Jhonier-Rojas/proyecto-modulo-meteorologico-esp32-s3/PI__SEMESTRE.kicad_pcb

## KiCad design PI__SEMESTRE.kicad_pcb (2026-05-23)

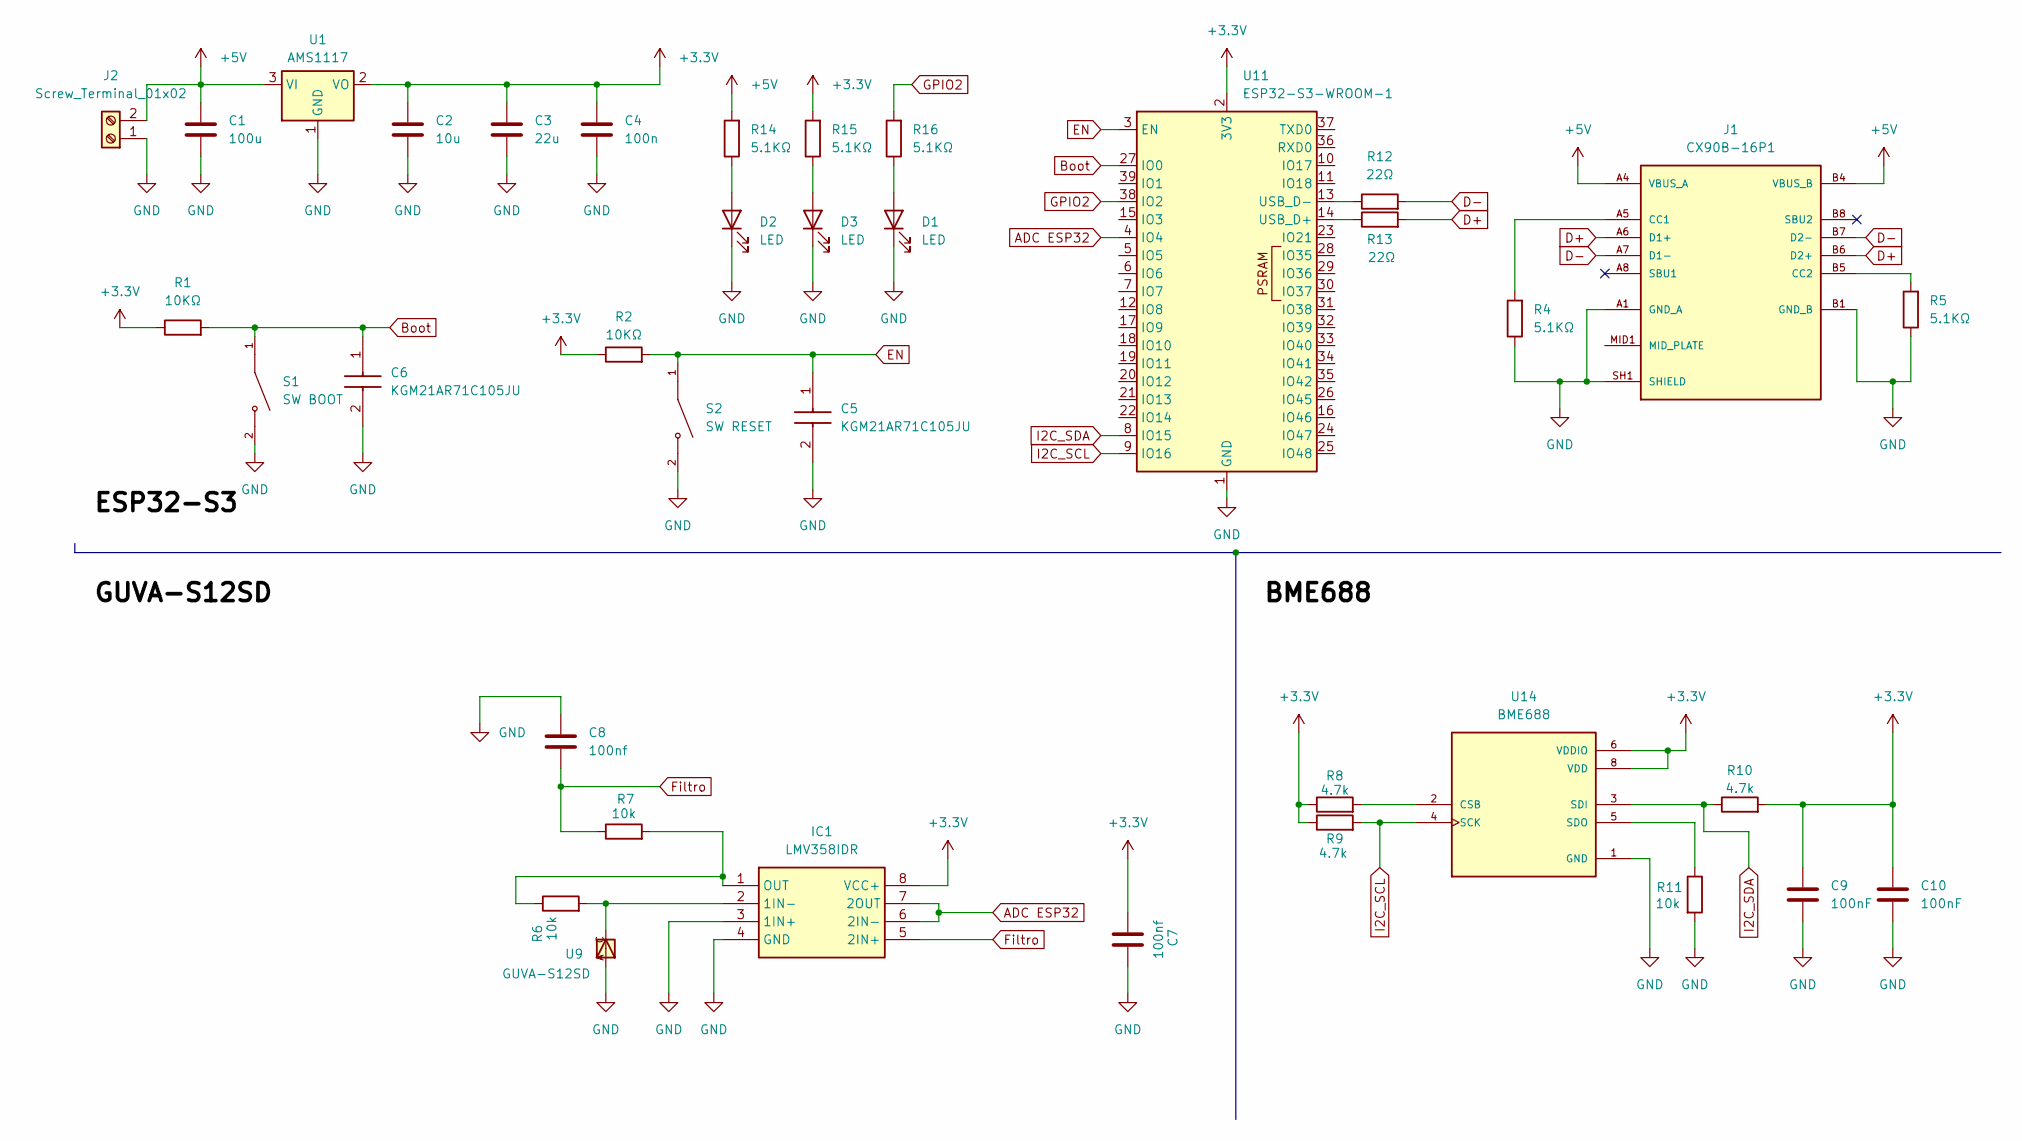
[picture p1: schematic PI__SEMESTRE.kicad_sch]

Parts:
C1: 100u; C_0805_2012Metric
C2: 10u; C_0805_2012Metric
C3: 22u; C_0805_2012Metric
C4: 100n; C_0805_2012Metric
C5, C6: KGM21AR71C105JU; CAPC2012X145N; Mouser Part Number 581-KGM21AR71C105JU
C7, C8: 100nf; C_0805_2012Metric
C9, C10: 100nF; C_0805_2012Metric
D1, D2, D3: LED; LED_1206_3216Metric
IC1: LMV358IDR; SOIC127P600X175-8N; Mouser Part Number 595-LMV358IDR
J1: CX90B-16P1; HIROSE_CX90B-16P1; PARTREV 23.04.05
J2: Screw_Terminal_01x02
R1, R2: 10KΩ; R_0805_2012Metric
R4, R5, R14, R15, R16: 5.1KΩ; R_0805_2012Metric
R6, R7, R11: 10k; R_0805_2012Metric
R8, R9, R10: 4.7k; R_0805_2012Metric
R12, R13: 22Ω; R_0805_2012Metric
S1: SW BOOT; SW_TS-1088-AR02016; PARTREV N/A
S2: SW RESET; SW_TS-1088-AR02016; PARTREV N/A
U1: AMS1117; SOT-223-3_TabPin2
U9: GUVA-S12SD; MPN GUVA-S12SD
U11: ESP32-S3-WROOM-1; XCVR_ESP32-S3-WROOM-1U-N16R8
U14: BME688; IC_BME688; PARTREV 1.0

Connections:
+3.3V: C2.1, C3.1, C4.1, C7.2, C9.1, C10.1, IC1.8 (VCC+), R1.1, R2.1, R8.1, R9.1, R10.2, R15.2, U1.2 (VO), U11.2 (3V3), U14.6 (VDDIO), U14.8 (VDD)
+5V: C1.1, J1.A4 (VBUS_A), J1.A9 (VBUS_A), J1.B4 (VBUS_B), J1.B9 (VBUS_B), J2.2, R14.2, U1.3 (VI)
ADC ESP32: IC1.6 (2IN-), IC1.7 (2OUT), U11.4 (IO4)
Boot: C6.1, R1.2, S1.1, U11.27 (IO0)
D+: J1.A6 (D1+), J1.B6 (D2+), R13.2
D-: J1.A7 (D1-), J1.B7 (D2-), R12.2
EN: C5.1, R2.2, S2.1, U11.3 (EN)
Filtro: C8.1, IC1.5 (2IN+), R7.1
GND: C1.2, C2.2, C3.2, C4.2, C5.2, C6.2, C7.1, C8.2, C9.2, C10.2, D1.1 (K), D2.1 (K), D3.1 (K), IC1.3 (1IN+), IC1.4 (GND), J1.A1 (GND_A), J1.A12 (GND_A), J1.B1 (GND_B), J1.B12 (GND_B), J1.SH1 (SHIELD), J1.SH2 (SHIELD), J1.SH3 (SHIELD), J1.SH4 (SHIELD), J1.SH5 (SHIELD), J1.SH6 (SHIELD), J2.1, R4.1, R5.1, R11.2, S1.2, S2.2, U1.1 (GND), U9.A, U11.1 (GND), U11.40 (GND), U11.41 (GND), U14.1 (GND), U14.7 (GND)
GPIO2: R16.2, U11.38 (IO2)
I2C_SCL: R9.2, U11.9 (IO16), U14.4 (SCK)
I2C_SDA: R10.1, U11.8 (IO15), U14.3 (SDI)
unnamed: D1.2 (A), R16.1
unnamed: D2.2 (A), R14.1
unnamed: D3.2 (A), R15.1
unnamed: IC1.2 (1IN-), R6.2, U9.C
unnamed: IC1.1 (OUT), R6.1, R7.2
unnamed: J1.A5 (CC1), R4.2
unnamed: J1.B5 (CC2), R5.2
unnamed: J1.MID1 (MID_PLATE), J1.MID2 (MID_PLATE)
unnamed: R13.1, U11.14 (USB_D+)
unnamed: R12.1, U11.13 (USB_D-)
unnamed: R8.2, U14.2 (CSB)
unnamed: R11.1, U14.5 (SDO)

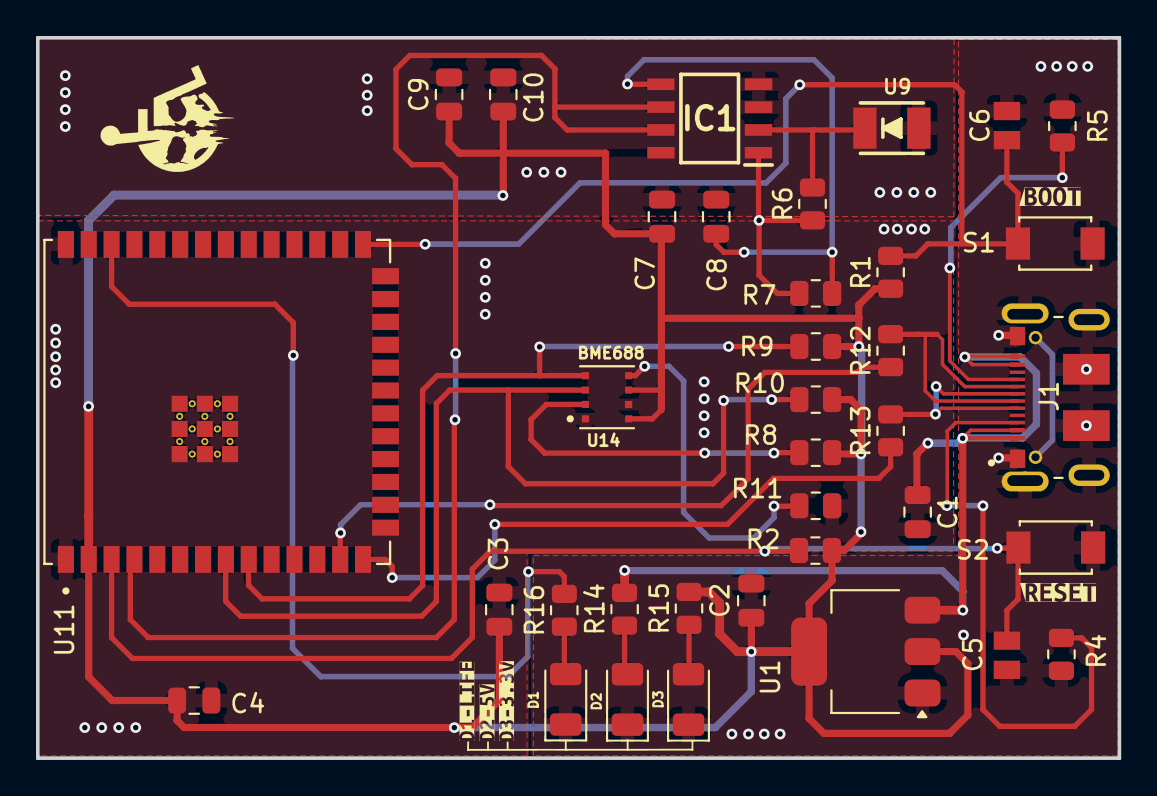
[picture p2: board PI__SEMESTRE.kicad_pcb from above]

Board: 2 copper layers, 60.1 x 40.0 mm, 41 parts (0 on the bottom side), 24 nets.

Other parts of the board:
kibuzzard-6A0FC9A7: G***; kibuzzard-6A0FC9A7
kibuzzard-6A0FC9CC: G***; kibuzzard-6A0FC9CC
kibuzzard-6A0FC95D: G***; kibuzzard-6A0FC95D
kibuzzard-6A0FCD51: G***; kibuzzard-6A0FCD51
kibuzzard-6A0FCD67: G***; kibuzzard-6A0FCD67
