Jhonier-Rojas/proyecto-modulo-meteorologico-esp32-s3/(commit log)

2026-04-24 primer commit del proyecto kicad
    [PI__SEMESTRE.kicad_pcb, PI__SEMESTRE.kicad_sch, bme688.kicad_sch, sin_título.kicad_sch]
2026-04-24 Unifico esquematicos y elimino hojas innecesarias
    [bme688.kicad_sch, sin_título.kicad_sch]
2026-04-26 cambios realizados para el esp32 s3 y unificacion de hojas
    [PI__SEMESTRE.kicad_pcb, PI__SEMESTRE.kicad_sch]
2026-04-26 Actualizo archivos KiCad
2026-04-26 se corrige el esquematico del BME688 que sugirio el profesor, se le colocan etiquetas a las conexiones al esp32.
    [PI__SEMESTRE.kicad_sch]
2026-04-27 se realizo los cambios que el profesor indico en la parte del guva s12sd, corrigiendo pistas, separando componentes y agregando el seguidor de voltaje que va desde nuestro filtro paso bajo hasta la e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
    [PI__SEMESTRE.kicad_sch]
2026-04-28 se implementan tanto huella y diseño 3D de los pulsadores booty reset, y tambien se le implementan la huella y diseño 3D a otros componentes como BME688, LMV358I, GUVA S12SD. se empieza a ordenar los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
    [PI__SEMESTRE.kicad_pcb, PI__SEMESTRE.kicad_sch]
2026-04-29 se empieza a realizar el diseño para la pcb se dejan los componentes pocisionados para luego hacer las pistas, se rellena el contorno de la placa con conexion GND.
    [PI__SEMESTRE.kicad_pcb, PI__SEMESTRE.kicad_sch]
2026-04-30 se colocan algunas pistas de potencia, se unifican las dos capas en una misma pcb se hace pruebas de tamaños
    [PI__SEMESTRE.kicad_pcb]
2026-05-01 Se deja ya lista la pcb para que el profesor pase revision y noos indique los errores a corregir
    [PI__SEMESTRE.kicad_pcb]
2026-05-04 algunas correcciones del profesor
    [PI__SEMESTRE.kicad_pcb, PI__SEMESTRE.kicad_sch]
2026-05-07 se hacen los cambios de las pistas esquineras de (90 Grados) a curvas de (45 Grados) estos cambios solamente se le hicieron a las pistas azules, se le agrega la conexion del led faltante del (ESP) pa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
    [PI__SEMESTRE.kicad_pcb, PI__SEMESTRE.kicad_sch]
2026-05-08 empece atrabajar las pistas rojas de la pcb
    [PI__SEMESTRE.kicad_pcb]
2026-05-11 Se corrigió el tamaño de algunas pistas y también se ajustaron las curvas en las esquinas, con el fin de evitar terminaciones en punta. De esta manera, las pistas quedan con un trazado más limpio, un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
    [PI__SEMESTRE.kicad_pcb]
2026-05-11 se termino de verificar las pistas, su anchor y se corrigió la curva de las pistas
    [PI__SEMESTRE.kicad_pcb]
2026-05-11 se corrigen las pistas del usb-c, se corrigen las pistas azules a rectas a 45 grados.
    [PI__SEMESTRE.kicad_pcb]
2026-05-11 se realizo la correcion del anchor de las pistas y en lo posible quedaran a 45 grados
2026-05-11 se corrigio anchor de unas pistas y su angulo a 45 grados
    [PI__SEMESTRE.kicad_pcb]
2026-05-11 se corrigio el angulo y el ancho de las pistas que faltaban
    [PI__SEMESTRE.kicad_pcb]
2026-05-12 se corrigen direcciones, curvas y tamaños de pistas
2026-05-15 se hicieron los cambios posibles que sugirio el docente, se cambiaron pistas a 45 grados se elimino los valores de los condensadores y resistencias, se hizo tambien el cambio proctecion contra ruido 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
    [PI__SEMESTRE.kicad_pcb]
2026-05-19 se actualizo la serigrafia en la pcb
    [PI__SEMESTRE.kicad_pcb]
2026-05-21 se organizo el tamaño de las pistas
    [PI__SEMESTRE.kicad_pcb]
2026-05-22 se corrigieron muchoss errores tanto que al diseño pcb le hacian falta 4 capacitores porque no tenian huella suministrada, se hicieron cambios de serigrafia, se acomodaron algunos errores tanto de la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
    [PI__SEMESTRE.kicad_pcb, PI__SEMESTRE.kicad_sch]
2026-05-22 fix: se solucionan algunos errores de clearance y planos de tierra
    [PI__SEMESTRE.kicad_pcb]
2026-05-22 se voltean las resistencias de la cara de abajo
    [PI__SEMESTRE.kicad_pcb]
2026-05-23 se corrigieron los condensadores que estaban en la parte de atraas de la placa
2026-05-23 se corrigio lo que sugerio el docente, pasando los componentes que estaban en la parte de atras de la placa
    [PI__SEMESTRE.kicad_pcb]
2026-05-23 se agrega nuestro logo se hacen las ultimos cambios para mandar hacer la pcb
    [PI__SEMESTRE.kicad_pcb]
2026-05-23 ing pruebas de fabricacion
    [PI__SEMESTRE.kicad_pcb]
2026-05-23 se hicieroon cambios pequeños
    [PI__SEMESTRE.kicad_pcb, PI__SEMESTRE.kicad_sch]
2026-05-23 se eliminaron componentes demas
    [PI__SEMESTRE.kicad_pcb]
